JStone2934/gaugepunk/(commit log)

2026-05-16 初始化项目: Ubuntu CPU/GPU 占用率驱动模拟电流表
    通过 USB 串口把上位机的 CPU/GPU 占用率发送到 ESP32-WROOM,
    由 ESP32 用 LEDC PWM 驱动两块 5mA 模拟电流表显示.
    包含:
    - host/: Python 上位机, 用 psutil + nvidia-ml-py 采集, 串口自动发现+重连
    - firmware/platformio + firmware/arduino: ESP32 固件双版本,
    独立校准 CPU/GPU 占空比, 32kHz PWM 消除可听啸叫
    - host/calibrate.py: 手动校准工具
    - docs/wiring.md: 限流电阻 + 接线图说明
    - environment.yml / requirements.txt: conda + pip 依赖
    当前校准: CPU cap=13.5%, GPU cap=100%, 适配 5mA 表头 + 1kΩ 限流.
2026-05-16 新增打包脚本与 systemd 开机自启支持
    scripts/ 提供一键安装的 system 级 systemd 服务:
    - monitor-run.sh: 启动包装, 自动定位 conda 并激活环境
    - monitor.service.template: 含 SupplementaryGroups=dialout, 解决
    不重新登录就拿不到串口权限的问题; 真正实现开机自启 (不依赖桌面登录)
    - install-service.sh / uninstall-service.sh: 一次 sudo 装好/卸载
    - start.sh: 不走 systemd 的手动前台启动 (调试用)
    README 增加 "打包部署 / 开机自启" 一节, 列常用 systemctl / journalctl 命令.
2026-05-16 项目正式命名为 GaugePunk
    - README 标题改为 GaugePunk, 增加 tagline
    - 固件 boot 输出 ASCII art logo, 启动即可见品牌标识
    - systemd service Description 改名
    - Python 包 docstring 更新
2026-05-16 全面对齐 GaugePunk 命名
    - conda 环境名: monitor -> gaugepunk (environment.yml)
    - 启动包装脚本: scripts/monitor-run.sh -> scripts/gaugepunk-run.sh
    - 环境变量: MONITOR_CONDA_ENV -> GAUGEPUNK_CONDA_ENV
    - systemd unit: monitor.service -> gaugepunk.service (含模板)
    - Arduino 工程: firmware/arduino/monitor/monitor.ino
    -> firmware/arduino/gaugepunk/gaugepunk.ino
    - README 全面重写以匹配新命名, 顺带补完校准/啸叫处理章节
2026-05-16 修复 systemd 服务 ExecStart 指向不存在的脚本
    模板里写的是 monitor-run.sh, 但实际脚本叫 gaugepunk-run.sh,
    导致 systemd 启动时 exec 失败 (status=203/EXEC), 服务无限重启,
    指针不动. 顺手修正注释里残留的旧 unit 名 monitor -> gaugepunk.
2026-05-17 上位机新增 Windows 平台支持
2026-05-17 新增 Windows 托盘版与 PyInstaller 单文件打包
2026-05-17 图标改为圆形裁剪 (alpha 抗锯齿)
2026-05-17 新增 GitHub Actions 自动发布工作流
2026-05-17 校准移到上位机 (host/config.yaml meters), 固件 cap 改为直通
